akira215/espHeat/PCB/screenshot/zVMC_PCB top.png

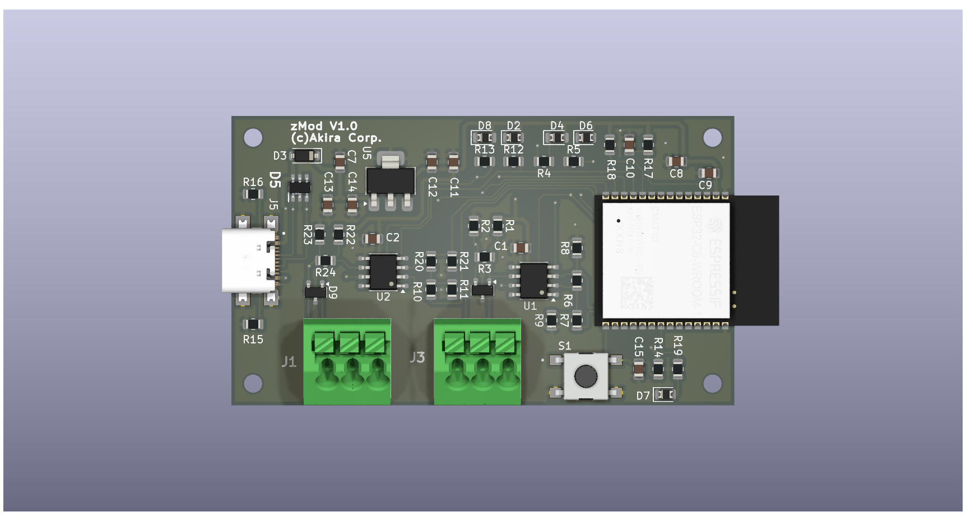
PCB/screenshot/zVMC_PCB top.png
