akira215/espHeat/PCB/screenshot/zHeat Connections.png

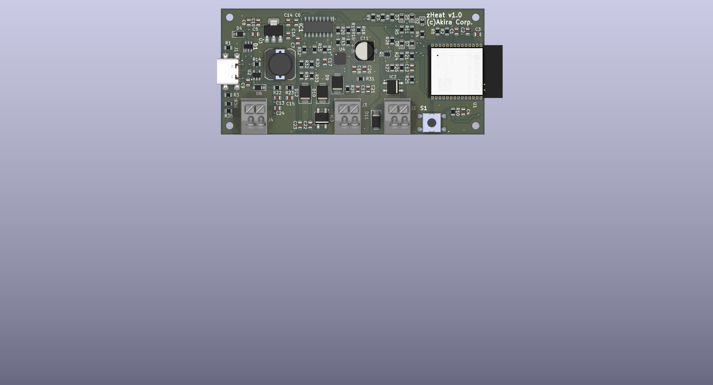
PCB/screenshot/zHeat Connections.png
