akira215/espHeat/3Dprint/screenshot/Slicer params.png

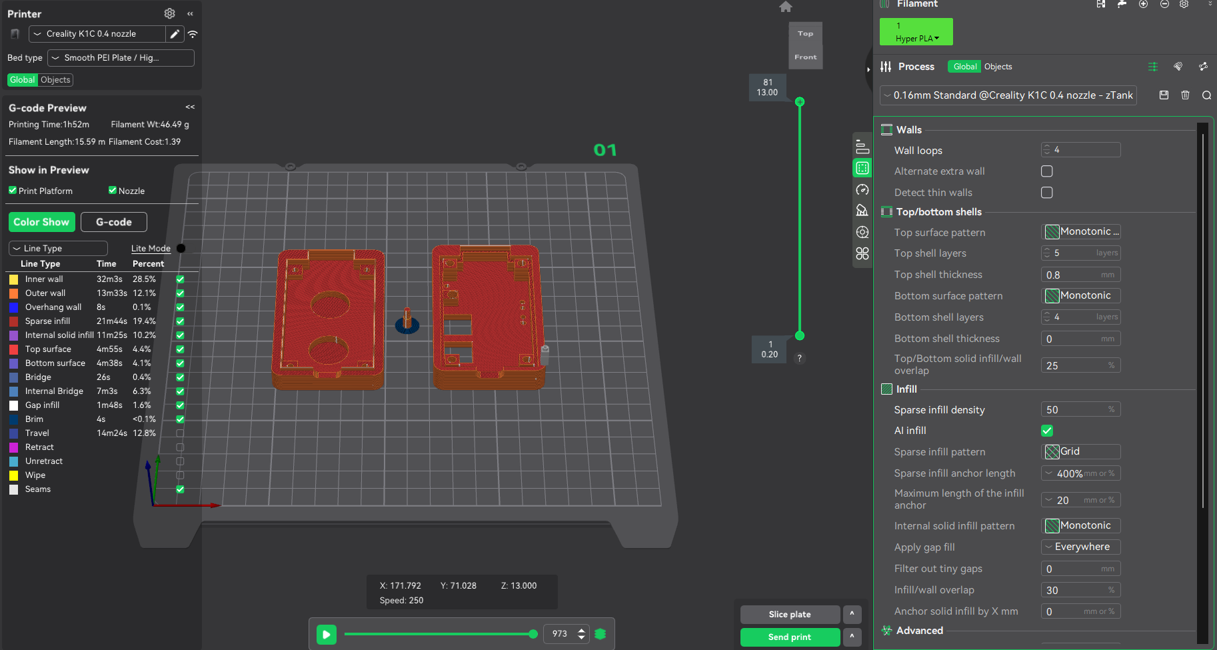
3Dprint/screenshot/Slicer params.png
