akira215/espHeat/PCB/screenshot/zHeat iso.png

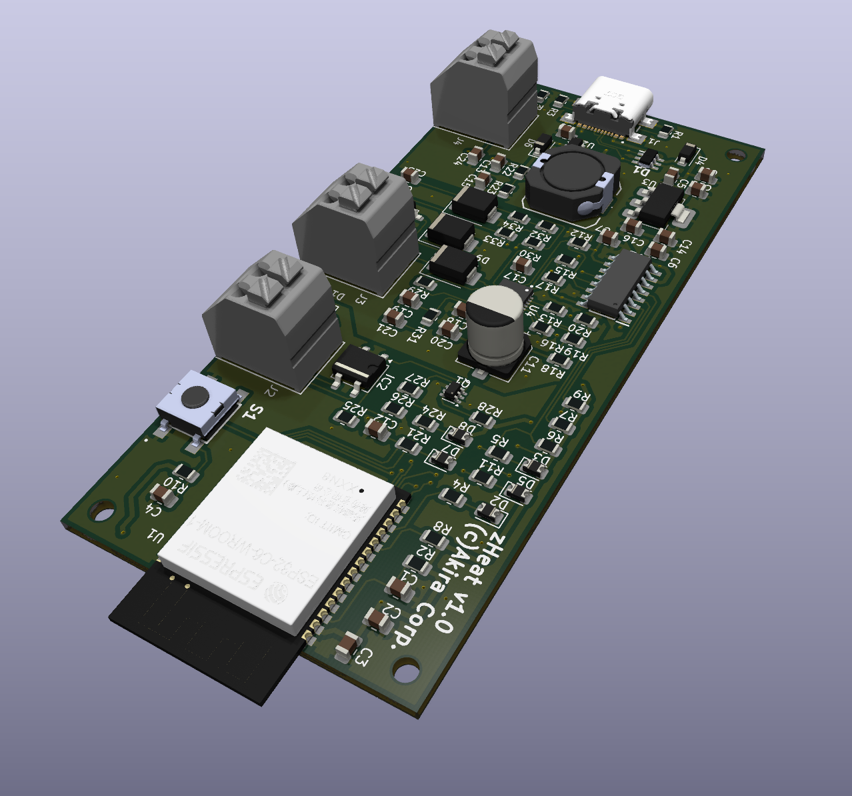
PCB/screenshot/zHeat iso.png
