akira215/espHeat/PCB/screenshot/zTank 4channel connector.png

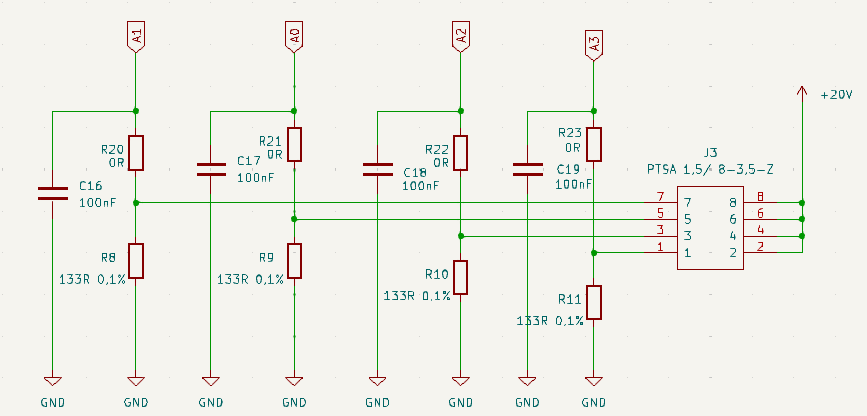
PCB/screenshot/zTank 4channel connector.png
