akira215/espHeat/PCB/screenshot/zTank ADS1115.png

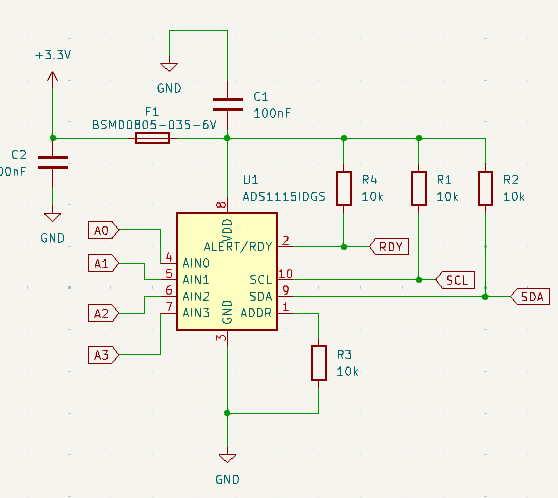
PCB/screenshot/zTank ADS1115.png
