akira215/espHeat/PCB/screenshot/zTank Connections.png

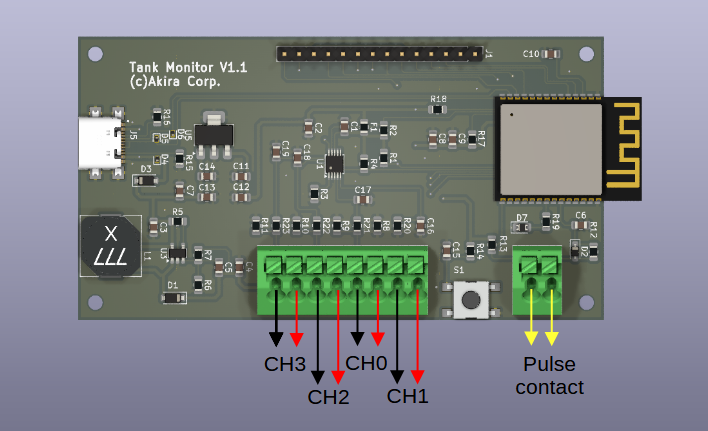
PCB/screenshot/zTank Connections.png
