akira215/espHeat/PCB/screenshot/zTank ESP32C6.png

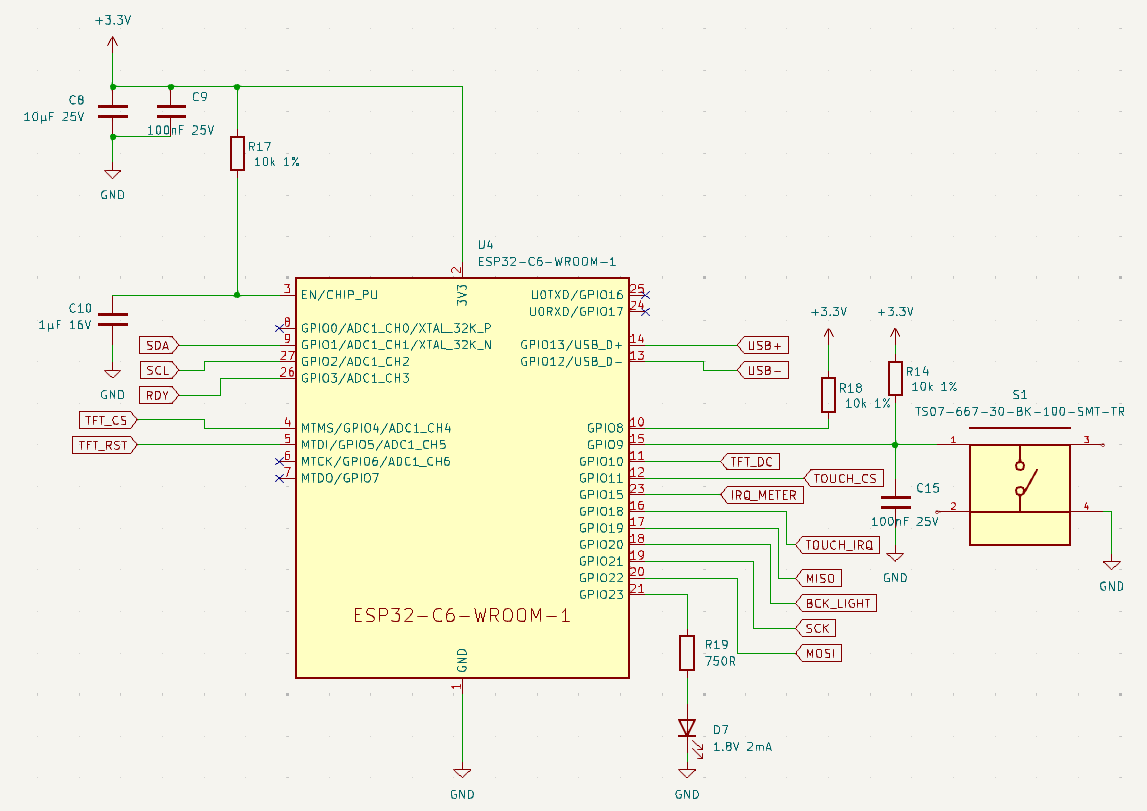
PCB/screenshot/zTank ESP32C6.png
