akira215/espHeat/PCB/screenshot/zTank Header.png

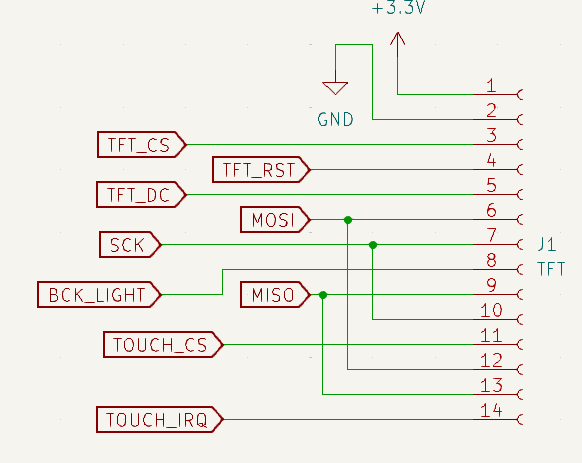
PCB/screenshot/zTank Header.png
