akira215/espHeat/PCB/screenshot/zTank LM2735X.png

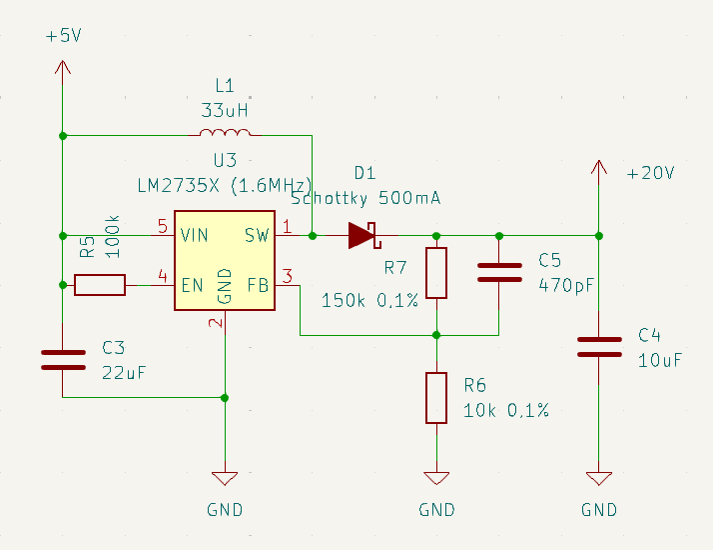
PCB/screenshot/zTank LM2735X.png
