akira215/espHeat/PCB/screenshot/zTank MCP1826S.png

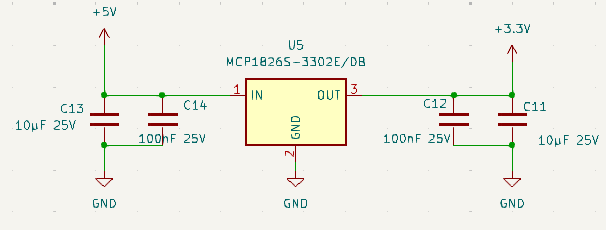
PCB/screenshot/zTank MCP1826S.png
