akira215/espHeat/PCB/screenshot/zTank Pulse contact.png

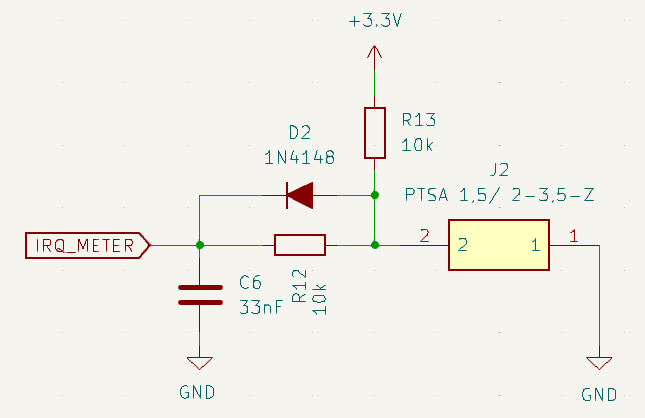
PCB/screenshot/zTank Pulse contact.png
