akira215/espHeat/PCB/screenshot/zTank USB.png

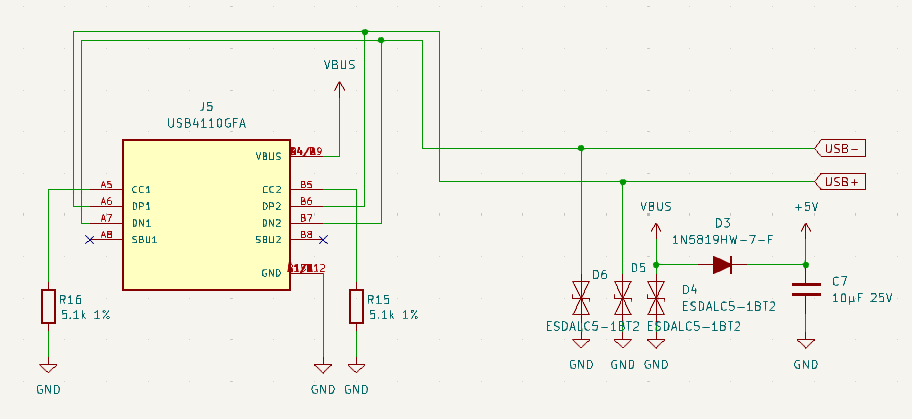
PCB/screenshot/zTank USB.png
