akira215/espHeat/PCB/screenshot/zTankV1_1 top-ortho.png

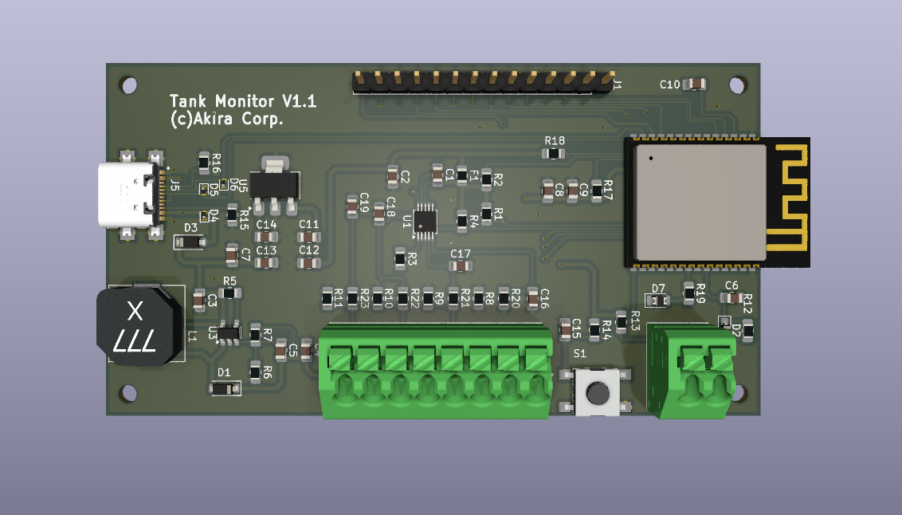
PCB/screenshot/zTankV1_1 top-ortho.png
