akira215/espHeat/PCB/screenshot/zVMC_PCB iso.png

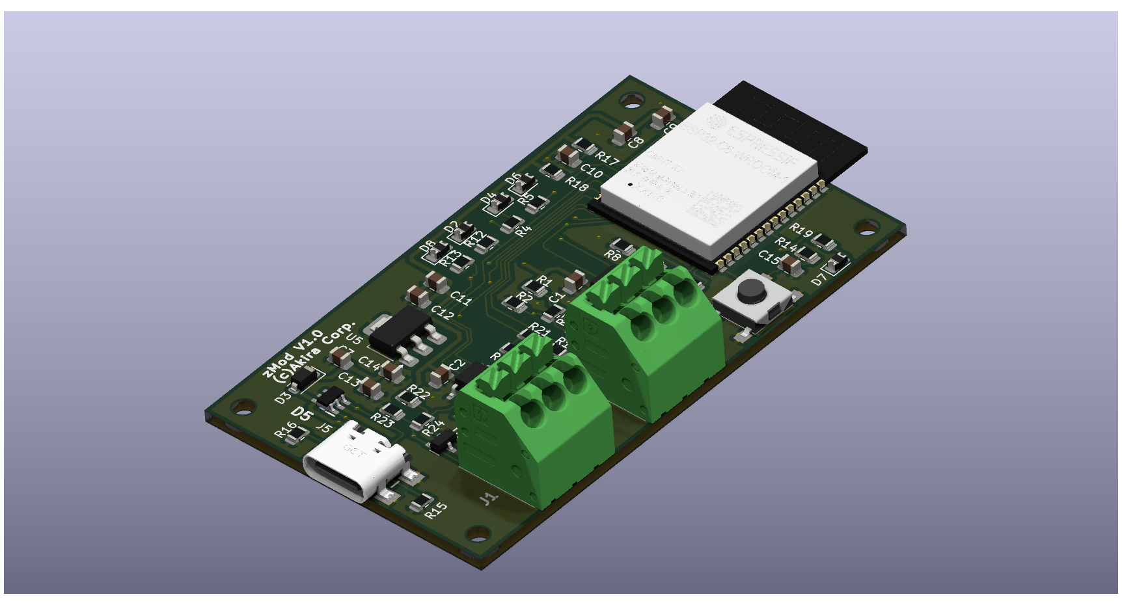
PCB/screenshot/zVMC_PCB iso.png
