akira215/espHeat/PCB/2026-06-10 Comput.ods

Sheet: Led
Resistor computation for LED
 | Power supply | Vf | 3,3 | V
 | Vf [V] | I [mA] | Ures [V] | R [Ω] | Ref | Link
LED Red | 1,8 | 2 | 1,5 | 750 | APT2012LSECK/J3-PRV | https://www.mouser.fr/ProductDetail/Kingbright/APT2012LSECK-J3-PRV?qs=6oMev5NRZMEkGJkKIsAalQ%3D%3D
LED Green | 2,65 | 2 | 0,65 | 325 | APT2012LZGCK | https://www.mouser.fr/ProductDetail/Kingbright/APT2012LZGCK?qs=6oMev5NRZMHOosFiXb%2F3qw%3D%3D
LED Yellow | 1,85 | 2 | 1,45 | 725 | APT2012LSYCK/J3-PRV | https://www.mouser.fr/ProductDetail/Kingbright/APT2012LSYCK-J3-PRV?qs=6oMev5NRZMGoWLCc4feqUg%3D%3D
LED Blue | 2,65 | 2 | 0,65 | 325 | APT2012LVBC/D | https://www.mouser.fr/ProductDetail/Kingbright/APT2012LVBC-D?qs=6oMev5NRZMGErJYT6KZLXg%3D%3D
LED Orange | 1,8 | 2 | 1,5 | 750 | APT2012LSECK/J4-PRV | https://www.mouser.fr/ProductDetail/Kingbright/APT2012LSECK-J4-PRV?qs=6oMev5NRZMH7xdB4zkudcw%3D%3D
 |  |  |  |  |  |  | OOPPPPPP¨TURTTHHJJKKL%MM%%%%%M¨%MLVJGLGUNUUPPGO PI./IH U?JJFV ? BNBNUTFTJTUJKGKG

Sheet: Bridge rectifier
 |  |  | GWD
Input | 12 | V | 12 | V
Bridge rectifier forward V /D | 1 | V | 0,5 | V
R to +Vcc | 8,2 | k | 6,8 | k
R to GND | 3,9 | k | 3,4 | k
Input MCU V | 3,22314049586777 | V | 3,66666666666667 | V
