akira215/espHeat/3Dprint/mHeat_enclosure.FCStd

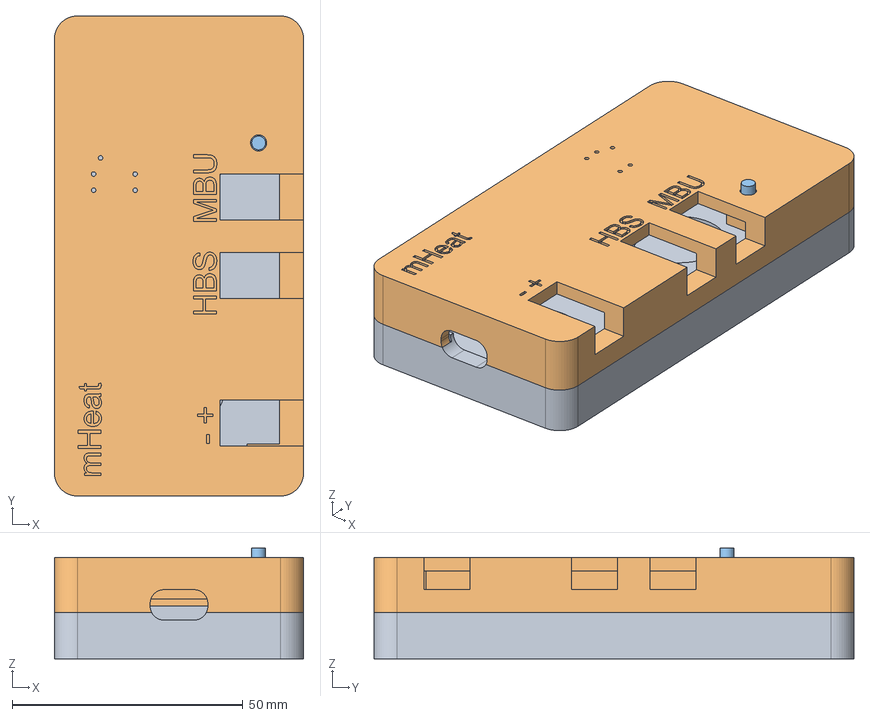
[picture p22: CAD file, 2026-11-06]
3Dprint/mHeat_enclosure.FCStd
54.0 x 104.0 x 24.0 mm
Enclosure_Bottom
Enclosure_Top
Button
