akira215/espHeat/3Dprint/STL/mHeat_enclosure-Enclosure_Top.stl

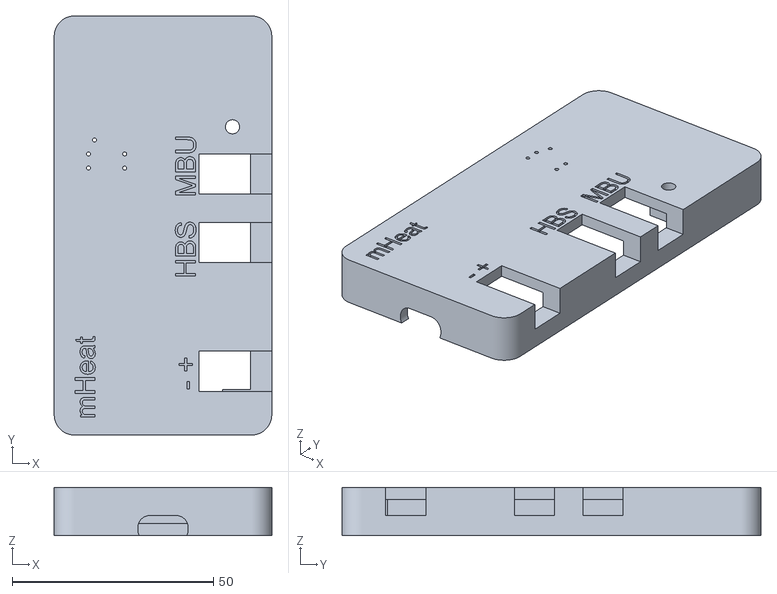
[picture p23: CAD file, 2026-11-06]
3Dprint/STL/mHeat_enclosure-Enclosure_Top.stl
54.0 x 104.0 x 12.0
