akira215/espHeat/3Dprint/mHeat_enclosure-Enclosure_Bottom.3mf

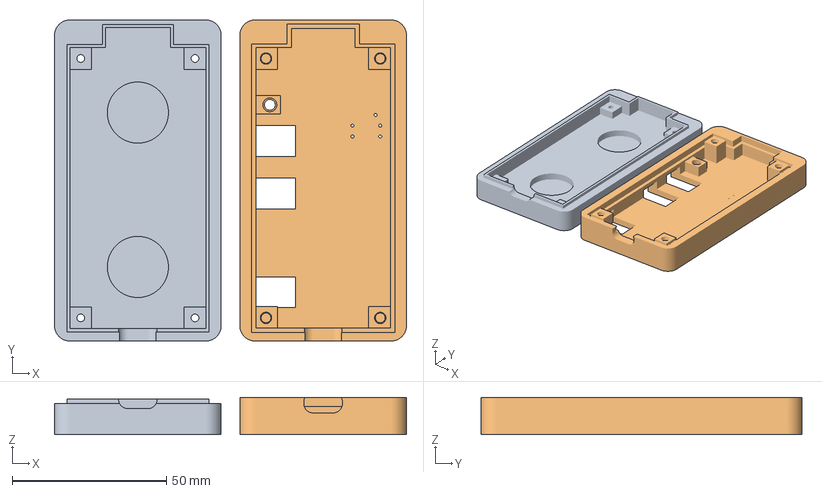
[picture p24: CAD file, 2026-11-06]
3Dprint/mHeat_enclosure-Enclosure_Bottom.3mf
114.0 x 104.0 x 12.0 mm
mHeat_enclosure-Enclosure_Bottom.stl
mHeat_enclosure-Enclosure_Top.stl
