akira215/espHeat/3Dprint/STL/mHeat_enclosure-Button.stl

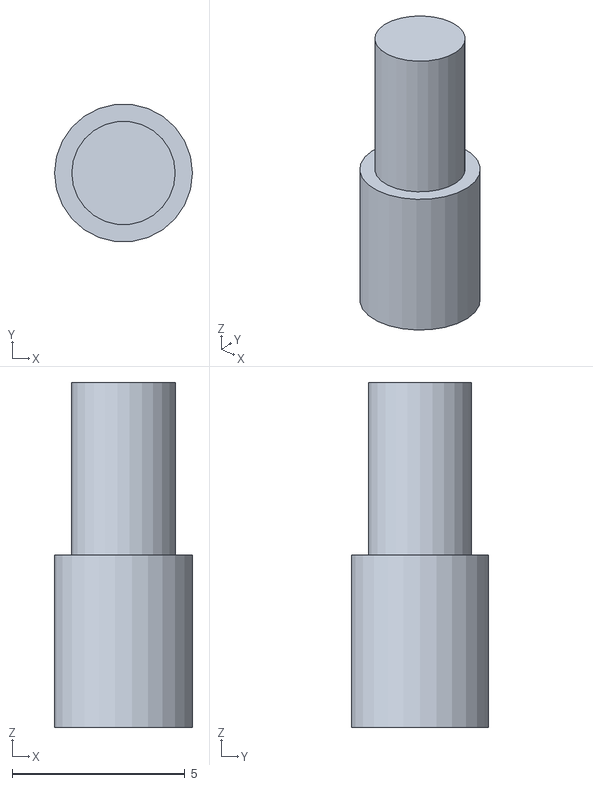
[picture p25: CAD file, 2026-11-06]
3Dprint/STL/mHeat_enclosure-Button.stl
4.00 x 3.97 x 10.0
