akira215/espHeat/(list of files, cad)

Other CAD files:
3Dprint/STL/mHeat_enclosure-Enclosure_Bottom.stl
