akira215/espHeat/PCB/zHeat_PCB.kicad_pcb

## KiCad design PCB/zHeat_PCB.kicad_pcb (2026-11-06)

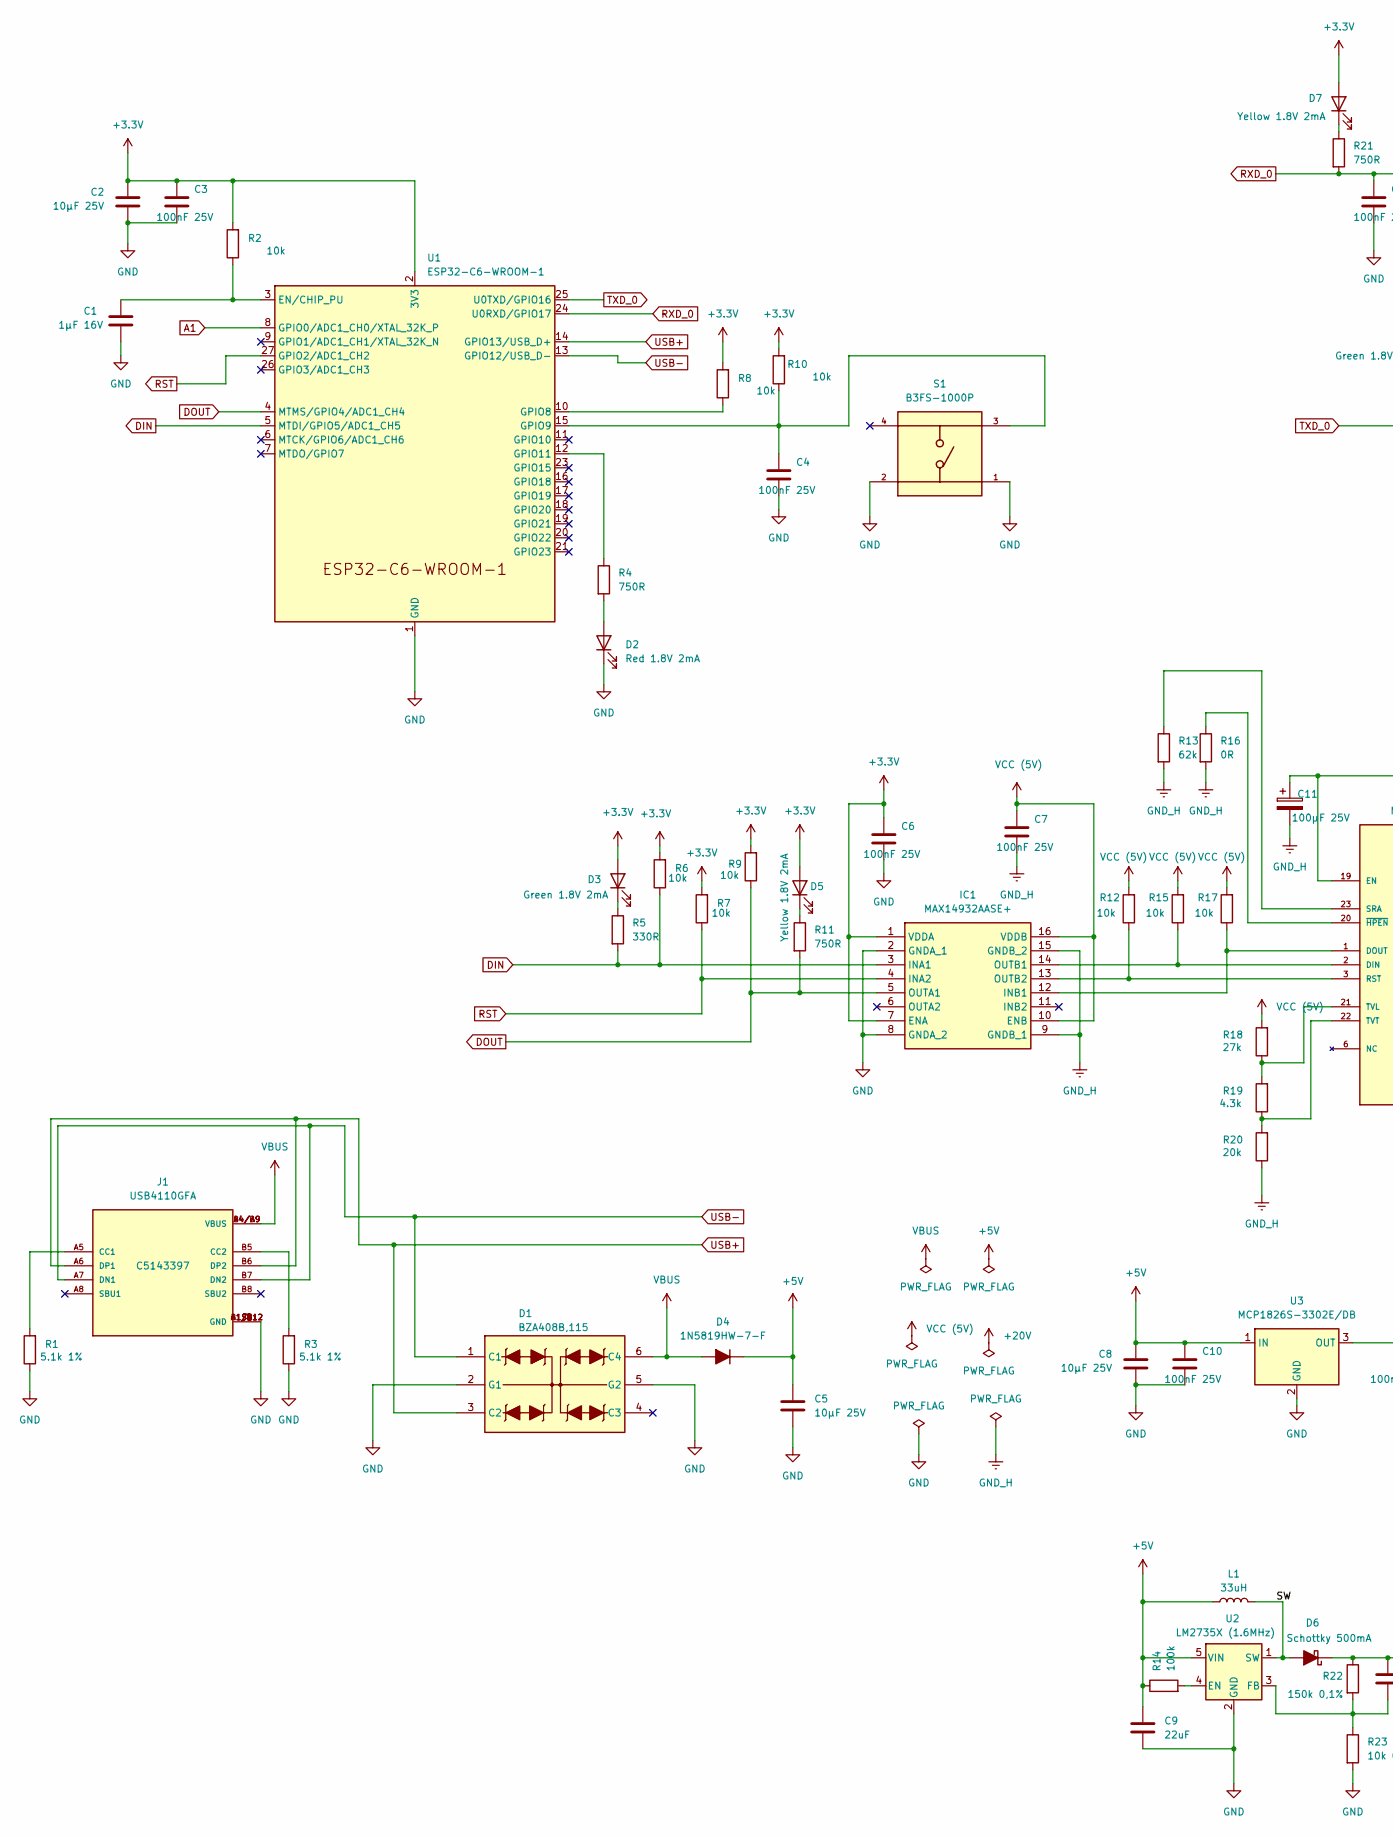
[picture p26: schematic zHeat_PCB.kicad_sch, part in row 1, column 1]

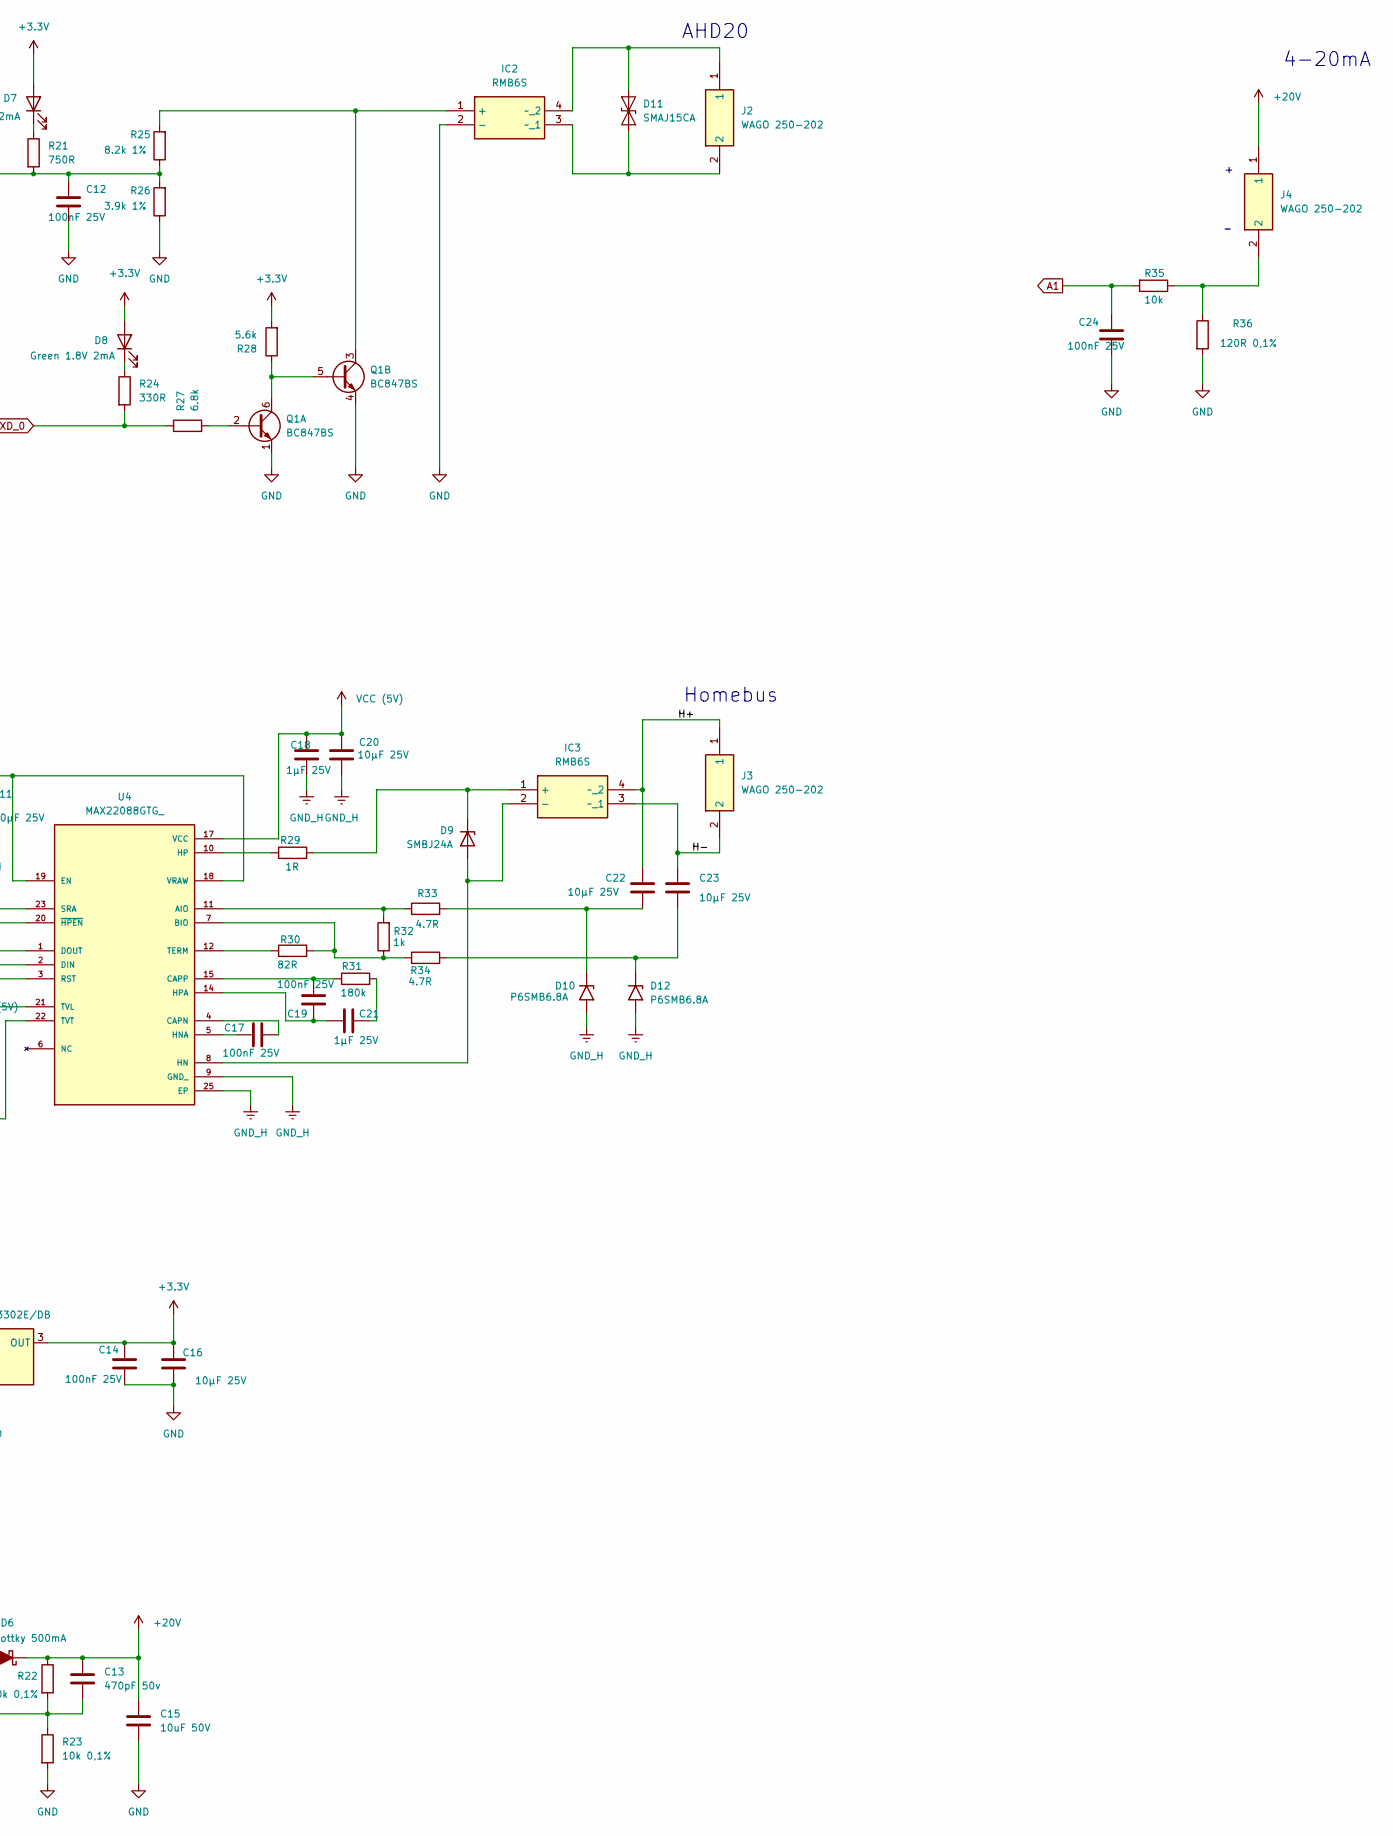
[picture p27: schematic zHeat_PCB.kicad_sch, part in row 1, column 2]

Parts:
C1: 1µF 16V; C_0805_2012Metric; LCSC C94122
C2, C5, C8, C16, C20, C22, C23: 10µF 25V; C_0805_2012Metric; LCSC C669099
C3, C4, C6, C7, C10, C12, C14, C17, C19, C24: 100nF 25V; C_0805_2012Metric; LCSC C519981
C9: 22uF; C_0805_2012Metric; LCSC C45783
C11: 100µF 25V; CP_Elec_6.3x7.7; LCSC C2836443
C13: 470pF 50v; C_0805_2012Metric; LCSC C1743
C15: 10uF 50V; C_0805_2012Metric; LCSC C22367830
C18, C21: 1µF 25V; C_0805_2012Metric; LCSC C91186
D1: BZA408B,115; SOT95P275X110-6N; Mouser Part Number 771-BZA408B,125
D2: Red 1.8V 2mA; D_0805_2012Metric; LCSC C5879380
D3, D8: Green 1.8V 2mA; D_0805_2012Metric; LCSC C5569446
D4: 1N5819HW-7-F; D_SOD-123; LCSC C82544
D5, D7: Yellow 1.8V 2mA; D_0805_2012Metric; LCSC C5879382
D6: Schottky 500mA; D_SOD-123; LCSC C52747980
D9: SMBJ24A; D_SMB; LCSC C224017
D10, D12: P6SMB6.8A; D_SMB; LCSC C2758562
D11: SMAJ15CA; D_SMA; LCSC C110044
IC1: MAX14932AASE+; SOIC127P600X175-16N; Mouser Part Number 700-MAX14932AASE+
IC2, IC3: RMB6S; TO-269AA; Mouser Part Number 512-MB1S
J1: USB4110GFA; GCT_USB4110GFA; LCSC C5143397
J2, J3, J4: WAGO 250-202; CONN2_250-202_WAG; Mouser Part Number 651-1985195
L1: 33uH; CDRH104RNP330NC; LCSC C225051
Q1: BC847BS; SOT-363_SC-70-6; LCSC C8653
R1, R3: 5.1k 1%; R_0805_2012Metric; LCSC C27834
R2, R6, R7, R8, R9, R10, R12, R15, R17, R35: 10k; R_0805_2012Metric; LCSC C17414
R4, R11, R21: 750R; R_0805_2012Metric; LCSC C17818
R5, R24: 330R; R_0805_2012Metric; LCSC C17630
R13: 62k; R_0805_2012Metric; LCSC C17783
R14: 100k; R_0805_2012Metric; LCSC C100049
R16: 0R; R_0805_2012Metric; LCSC C174076
R18: 27k; R_0805_2012Metric; LCSC C114533
R19: 4.3k; R_0805_2012Metric; LCSC C137518
R20: 20k; R_0805_2012Metric; LCSC C4328
R22: 150k 0,1%; R_0805_2012Metric; LCSC C136927
R23: 10k 0,1%; R_0805_2012Metric; LCSC C110775
R25: 8.2k 1%; R_0805_2012Metric; LCSC C17828
R26: 3.9k 1%; R_0805_2012Metric; LCSC C114221
R27: 6.8k; R_0805_2012Metric; LCSC C114550
R28: 5.6k; R_0805_2012Metric; LCSC C114538
R29: 1R; R_0805_2012Metric; LCSC C25271
R30: 82R; R_0805_2012Metric; LCSC C17841
R31: 180k; R_0805_2012Metric; LCSC C17501
R32: 1k; R_0805_2012Metric; LCSC C17513
R33, R34: 4.7R; R_0805_2012Metric; LCSC C17675
R36: 120R 0,1%; R_0805_2012Metric; LCSC C2989047
S1: B3FS-1000P; PARTREV 1.0; LCSC C271750
U1: ESP32-C6-WROOM-1; LCSC C5366877
U2: LM2735X (1.6MHz); SOT-23-5; LCSC C555454
U3: MCP1826S-3302E/DB; SOT-223-3_TabPin2; LCSC C638624
U4: MAX22088GTG_; QFN50P400X400X80-25N; PARTREV 4; LCSC C5258925

Connections:
+3.3V: C2.1, C3.1, C6.1, C14.1, C16.1, D3.2 (A), D5.2 (A), D7.2 (A), D8.2 (A), IC1.1 (VDDA), IC1.7 (ENA), R2.2, R6.2, R7.2, R8.2, R9.2, R10.2, R28.2, U1.2 (3V3), U3.3 (OUT)
+5V: C5.1, C8.1, C9.1, C10.1, D4.1 (K), L1.1, R14.1, U2.5 (VIN), U3.1 (IN)
+20V: C13.1, C15.1, D6.1 (K), J4.1, R22.1
/H+: C22.1, IC3.4 (~_2), J3.1
/H-: C23.1, IC3.3 (~_1), J3.2
/SW: D6.2 (A), L1.2, U2.1 (SW)
A1: C24.1, R35.2, U1.8 (GPIO0/ADC1_CH0/XTAL_32K_P)
DIN: IC1.3 (INA1), R5.2, R6.1, U1.5 (MTDI/GPIO5/ADC1_CH5)
DOUT: IC1.5 (OUTA1), R9.1, R11.2, U1.4 (MTMS/GPIO4/ADC1_CH4)
GND: C1.2, C2.2, C3.2, C4.2, C5.2, C6.2, C8.2, C9.2, C10.2, C12.2, C14.2, C15.2, C16.2, C24.2, D1.2 (G1), D1.5 (G2), D2.1 (K), IC1.2 (GNDA_1), IC1.8 (GNDA_2), IC2.2 (-), J1.A1/B12 (GND), J1.B1/A12 (GND), J1.S1 (GND), J1.S2 (GND), J1.S3 (GND), J1.S4 (GND), Q1.1 (E1), Q1.4 (E2), R1.1, R3.1, R23.2, R26.1, R36.2, S1.1, S1.2, U1.1 (GND), U1.28 (GND), U1.29 (GND), U2.2 (GND), U3.2 (GND)
GND_H: C7.2, C11.2, C18.2, C20.2, D10.2 (A2), D12.2 (A2), IC1.9 (GNDB_1), IC1.15 (GNDB_2), R13.2, R16.2, R20.1, U4.9 (GND_), U4.16 (GND_), U4.25 (EP)
unnamed: C21.1, R31.2
unnamed: D2.2 (A), R4.2
unnamed: D3.1 (K), R5.1
unnamed: D5.1 (K), R11.1
unnamed: D7.1 (K), R21.1
unnamed: D8.1 (K), R24.1
unnamed: D9.2 (A), IC3.2 (-), U4.8 (HN)
unnamed: D9.1 (K), IC3.1 (+), R29.2
unnamed: C22.2, D10.1 (A1), R33.2
unnamed: D11.1 (A1), IC2.3 (~_1), J2.2
unnamed: D11.2 (A2), IC2.4 (~_2), J2.1
unnamed: C23.2, D12.1 (A1), R34.2
unnamed: IC1.12 (INB1), R17.1, U4.1 (DOUT)
unnamed: IC1.14 (OUTB1), R15.1, U4.2 (DIN)
unnamed: IC1.13 (OUTB2), R12.1, U4.3 (RST)
unnamed: IC2.1 (+), Q1.3 (C2), R25.2
unnamed: J1.A5 (CC1), R1.2
unnamed: J1.B5 (CC2), R3.2
unnamed: J4.2, R35.1, R36.1
unnamed: Q1.2 (B1), R27.2
unnamed: Q1.5 (B2), Q1.6 (C1), R28.1
unnamed: C1.1, R2.1, U1.3 (EN/CHIP_PU)
unnamed: R8.1, U1.10 (GPIO8)
unnamed: C4.1, R10.1, S1.3, U1.15 (GPIO9)
unnamed: R4.1, U1.12 (GPIO11)
unnamed: R14.2, U2.4 (EN)
unnamed: C13.2, R22.2, R23.1, U2.3 (FB)
unnamed: R32.2, R33.1, U4.11 (AIO)
unnamed: R30.2, R32.1, R34.1, U4.7 (BIO)
unnamed: C17.2, U4.4 (CAPN)
unnamed: C19.2, R31.1, U4.15 (CAPP)
unnamed: C11.1, U4.18 (VRAW), U4.19 (EN)
unnamed: C17.1, U4.5 (HNA)
unnamed: R29.1, U4.10 (HP)
unnamed: C19.1, C21.2, U4.14 (HPA)
unnamed: R13.1, U4.23 (SRA)
unnamed: R30.1, U4.12 (TERM)
unnamed: R18.1, R19.2, U4.21 (TVL)
unnamed: R19.1, R20.2, U4.22 (TVT)
unnamed: R16.1, U4.20 (~HPEN)
RST: IC1.4 (INA2), R7.1, U1.27 (GPIO2/ADC1_CH2)
RXD_0: C12.1, R21.2, R25.1, R26.2, U1.24 (U0RXD/GPIO17)
TXD_0: R24.2, R27.1, U1.25 (U0TXD/GPIO16)
USB+: D1.3 (C2), J1.A6 (DP1), J1.B6 (DP2), U1.14 (GPIO13/USB_D+)
USB-: D1.1 (C1), J1.A7 (DN1), J1.B7 (DN2), U1.13 (GPIO12/USB_D-)
VBUS: D1.6 (C4), D4.2 (A), J1.A4/B9 (VBUS), J1.B4/A9 (VBUS)
VCC (5V): C7.1, C18.1, C20.1, IC1.10 (ENB), IC1.16 (VDDB), R12.2, R15.2, R17.2, R18.2, U4.17 (VCC)

Notes on the sheet:
AHD20
Homebus
4-20mA

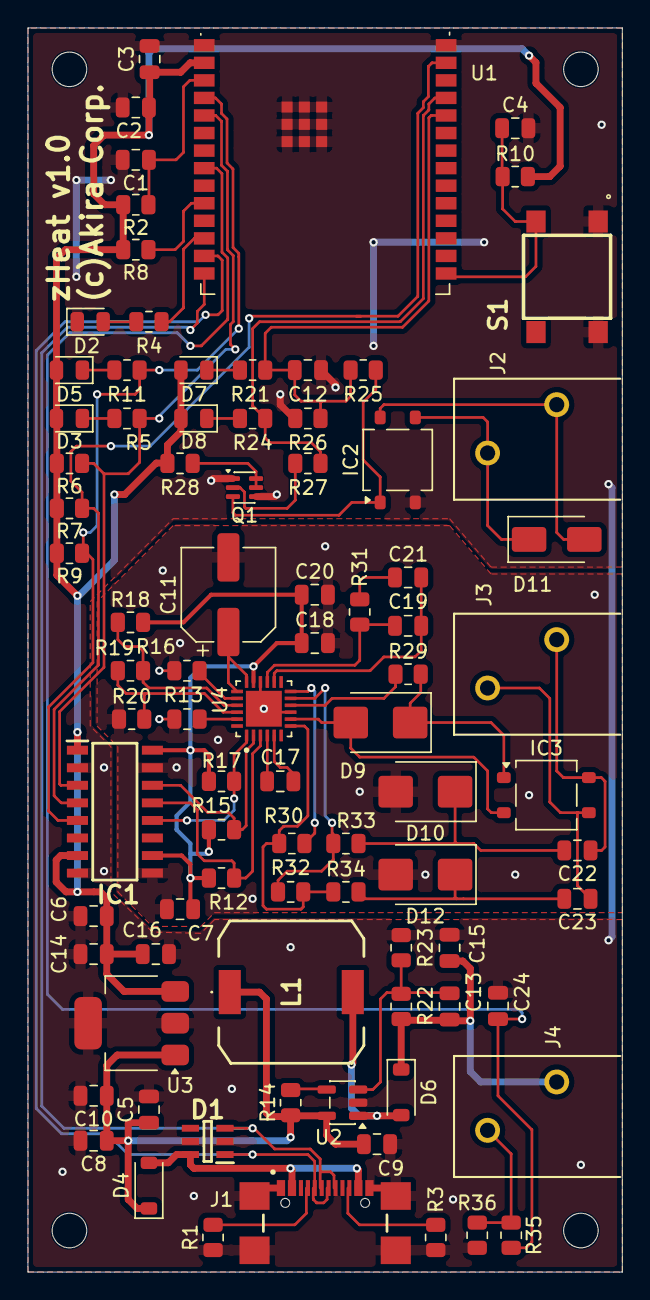
[picture p28: board zHeat_PCB.kicad_pcb from above]

Board: 2 copper layers, 43.0 x 90.0 mm, 86 parts (0 on the bottom side), 58 nets.
