akira215/espHeat/heat_components/espheat/driverDaikin.h

#pragma once


#include <vector>

// Driver class used for testing only
class DriverDaikin final
{
    static const uint8_t CRC_TABLE[];
public:
    DriverDaikin();
    ~DriverDaikin();

    void callback(const std::vector<uint8_t>& buffer);
private:
    static void printPacket(const std::vector<uint8_t>& data);
    static uint8_t computeCRC(const std::vector<uint8_t>& data);
    static void printDashboard();
};
