akira215/espHeat/(commit log)

2026-11-06 Initial commit (history reset)
    [espheat.cpp, espheat.h]
2026-11-06 adding framework
    [2026-06-10 Comput.ods, JLCPCB BOM.csv, bom.csv, designators.csv, mHeat_enclosure-Button.stl, mHeat_enclosure-Enclosure_Bottom.3mf, mHeat_enclosure-Enclosure_Bottom.stl, mHeat_enclosure-Enclosure_Top.stl]
